skysedge/sard_hardware/Daughterboard/BOM_RUSP_Daughterboard.ods

Qty | Stock | Description | Ref Des | Manufacturer | Part No. | Cost Each | Cost per ASM | Footprint
1 | 500 (+1000 One mXtend) | Antenna | AE1, | Ignion | NN02-232 | 0 | 0 | MyFootprints:XCVR_NN02-232
4 | 4000 DK | 47pF/50V | C1, C2, C3, C4, | Murata | GRM1555C1H470JA01D | 0 | 0 | Resistor_SMD:R_0603_1608Metric
3 | 12000 | .1uF/16V | C5, C44, C45, | Kemet | C0402C104K4RACTU | 0 | 0 | Capacitor_SMD:C_0603_1608Metric
1 | 0 | .9pF/HiQ | C6, | Murata | GJM1555C1HR90WB01 | 0 | 0 | Capacitor_SMD:C_0603_1608Metric
1 | 0 | 3.6pF/HiQ | C7, | Murata | GJM1555C1H3R6WB01 | 0 | 0 | Capacitor_SMD:C_0603_1608Metric
4 | 4000 ordered from Digikey | TVS/Varistor | D1, D2, D3, D4, | Littelfuse | PESD0402-140 | 0 | 0 | Resistor_SMD:R_0603_1608Metric
2 | 1000 + 1500 | 1N4148 Diode | D6, D7, | Diodes Incorporated | 1N4148W-13-F | 0.23 | 0.46 | Diode_SMD:D_SOD-123
1 | 4500 | u.FL | J1, | Molex | 734120110 | 0 | 0 | Connector_Coaxial:U.FL_Molex_MCRF_73412-0110_Vertical
1 | 475 +1000 | SIM Holder | J2, | JAE | SF7W006S1AR1000 | 2.05 | 2.05 | MyFootprints:SIMHolder_Amph7111S2015X02LF
2 | 380 | 12p Female Samtec Connector | J3, J6, | Samtec | FLE-106-01-G-DV | 0 | 0 | MyFootprints:Samtec_2x6HeaderSocket_FLE-106-01-G-DV
1 | 500 | MicroSD Holder | J7, | GCT | MEM2061-01-188-00-A | 0.74 | 0.74 | digikey-footprints:MicroSDSocket_GCT_MEM2061-01-188-00-A
1 | 35 (+1000 of EC2 cariant from onlinecomponents.com) | Relay | K1, | Kemet | EE2-3TNU | 1.42 | 1.42 | MyFootprints:Relay_Kemet_EE2-3TNU
1 | 0 | 15nH/HiQ | L2, | Murata | LQW18AN15NG00 | 0 | 0 | Inductor_SMD:L_0603_1608Metric
1 | 0 | 9.5nH/HiQ | L3, | Muarata | LQW18AN9N5G80 | 0 | 0 | Inductor_SMD:L_0603_1608Metric
1 | 0 | 7.5nH/HiQ | L4, | Murata | LQW18AN7N5C80 | 0 | 0 | Inductor_SMD:L_0603_1608Metric
3 | 5k DK | 100k | R31, R32, R33, | Yageo | RC0402FR-07100KL | 0 | 0 | Resistor_SMD:R_0603_1608Metric
1 | 10k | 10k | R34, | TE | CRGCQ0402J10K | 0 | 0 | Resistor_SMD:R_0603_1608Metric
1 | 100 (+ 400 on order from TI) + 600 DK | Logic Shifter | U11, | TI | TXB0104D | 0.99 | 0.99 | Package_SO:SOIC-14_3.9x8.7mm_P1.27mm
 |  |  |  |  |  | TOTAL: | 5.66
