skysedge/sard_hardware/Faceplate/BOM_RUSP_Faceplate.ods

Qty | Stock | Description | Ref Des | Manufacturer | Part No. | Cost Each | Cost per ASM | Footprint
4 | 0 | M2 SMT Nut | H1, H2, H3, H5, | PEM | SMTSO-M2-3ET | 0 | 0 | MyFootprints:SMTSO-M2-3ET
 |  |  |  |  |  | TOTAL: | Err:522
