skysedge/sard_hardware/(threads)

Thread 1 (2025-03-14):

Phase 2: Find new TP locatoins for testing

jhaupt, 2025-03-14:
For phase 2, reposition the test points so that the PQC fixture can be used even on a fully assembled phone. Potentially even with the casing on, if they're accessible via one of the hatches?
