skysedge/sard_hardware/(commit log)

2024-07-06 fixed 2560V/OLED reset routing
    [Daughterboard.kicad_pcb, OLEDDriver.kicad_sch, PowerManagement.kicad_sch, SARD_Motherboard.kicad_pcb, SARD_Motherboard.kicad_sch, USB_Bridge.kicad_sch]
2024-08-05 design fixes for first production run, v1.0
    [Daughterboard-1_Cu.gbr, Daughterboard-2_Cu.gbr, Daughterboard-3_Cu.gbr, Daughterboard-4_Cu.gbr, Daughterboard-B_Fab.gbr, Daughterboard-B_Mask.gbr, Daughterboard-B_Paste.gbr, Daughterboard-B_Silkscreen.gbr]
2024-08-05 Daughterboard rev'd to v1.0 for first production
    [Daughterboard-B_Mask.gbr, Daughterboard-B_Paste.gbr, Daughterboard-B_Silkscreen.gbr, Daughterboard-Edge_Cuts.gbr, Daughterboard-F_Mask.gbr, Daughterboard-F_Silkscreen.gbr, Daughterboard-L1_Cu.gbr, Daughterboard-L2_Cu.gbr]
